PubmarineSubmarine/pubmarine-submarine/images/PubSubColorShiftedTransparent.png

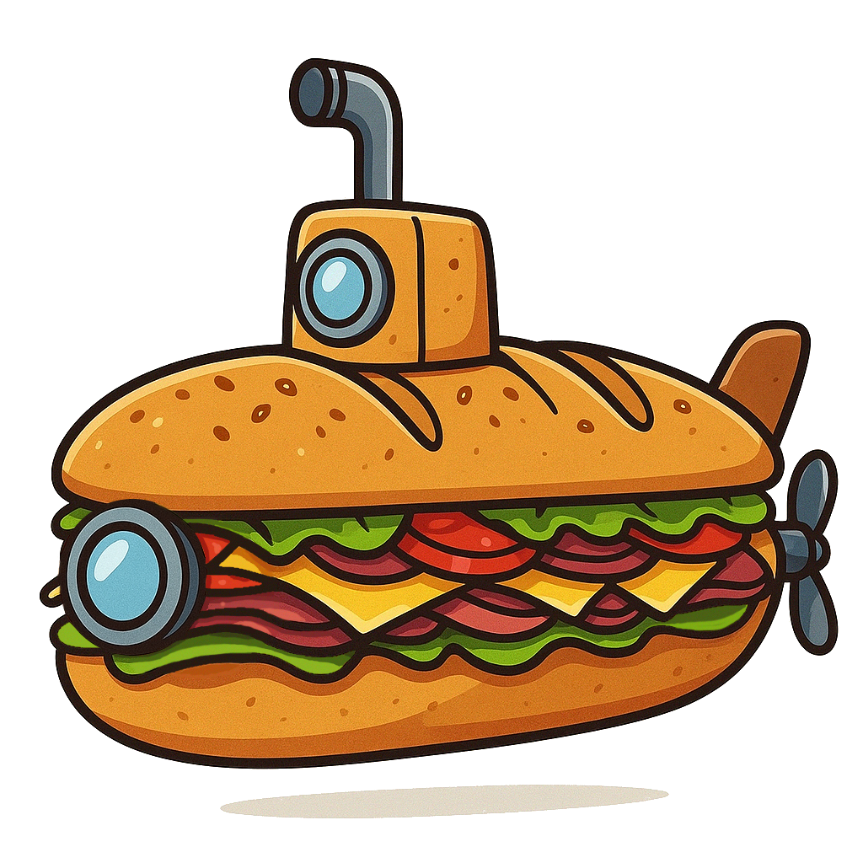
images/PubSubColorShiftedTransparent.png
