PubmarineSubmarine/pubmarine-submarine/images/PubSubBW1.png

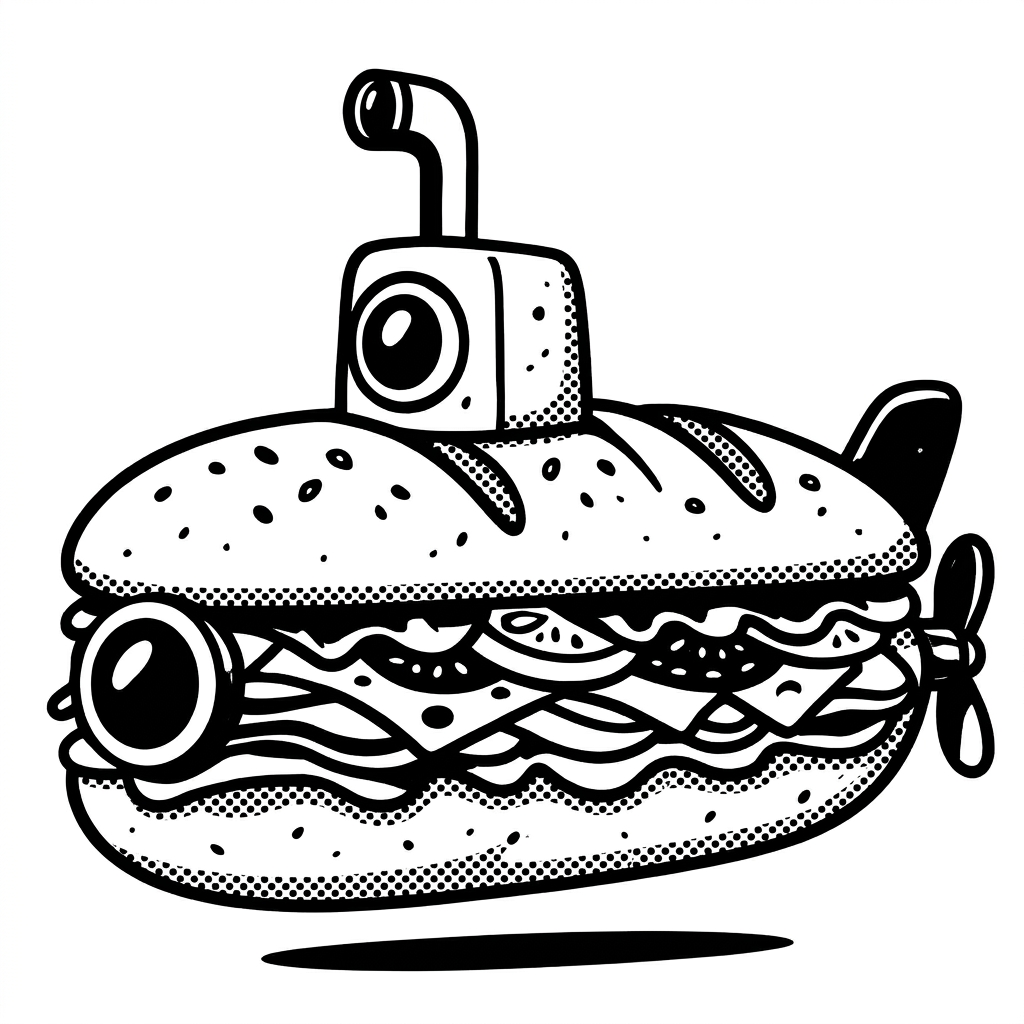
images/PubSubBW1.png
