PubmarineSubmarine/pubmarine-submarine/images/PubSubBW2.png

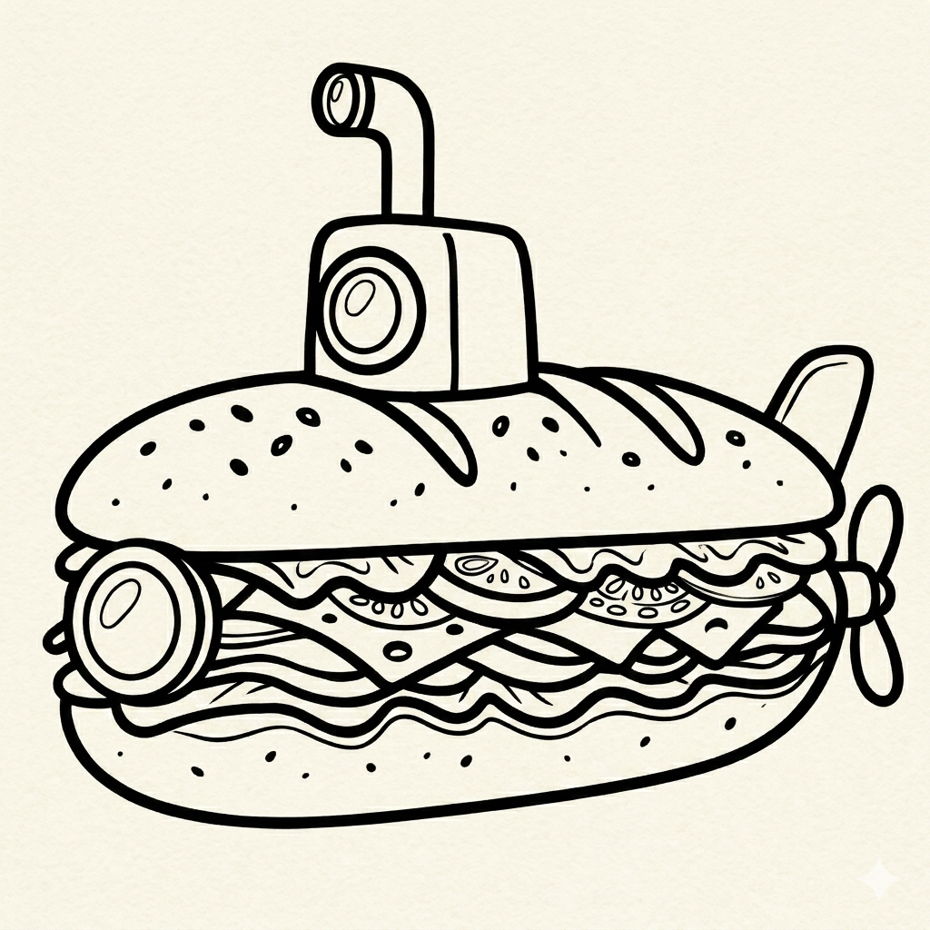
images/PubSubBW2.png
