PubmarineSubmarine/pubmarine-submarine/pcb/pubmarine-submarine.step

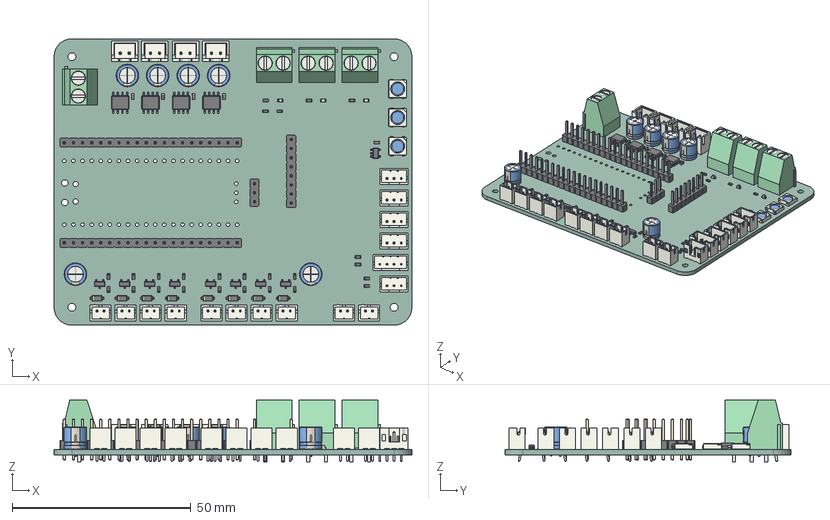
[picture p4: CAD file, 2025-08-23]
pcb/pubmarine-submarine.step
100.0 x 80.0 x 17.3 mm
JST_PH_B3B-PH-K_1x03_P2.00mm_Vertical x 5
CP_Radial_D6.3mm_P2.50mm x 6
R_0603_1608Metric x 25
JST_XH_B2B-XH-A_1x02_P2.50mm_Vertical x 4
C_0603_1608Metric x 5
JST_PH_B2B-PH-K_1x02_P2.00mm_Vertical x 10
LED_WS2812B_PLCC4_5.0x5.0mm_P3.2mm x 3
SOT-23 x 8
SO-8_3.9x4.9mm_P1.27mm x 4
TerminalBlock_Phoenix_MKDS-1,5-2_1x02_P5.00mm_Horizontal x 5
PinHeader_1x08_P2.54mm_Vertical
D_SOD-123 x 8
SOT-23-5
LED_0603_1608Metric x 3
PinHeader_1x20_P2.54mm_Vertical x 2
JST_PH_B4B-PH-K_1x04_P2.00mm_Vertical
PinHeader_1x03_P2.54mm_Vertical
pubmarine-submarine_PCB
