PubmarineSubmarine/pubmarine-submarine/web/static/subsanwich.obj

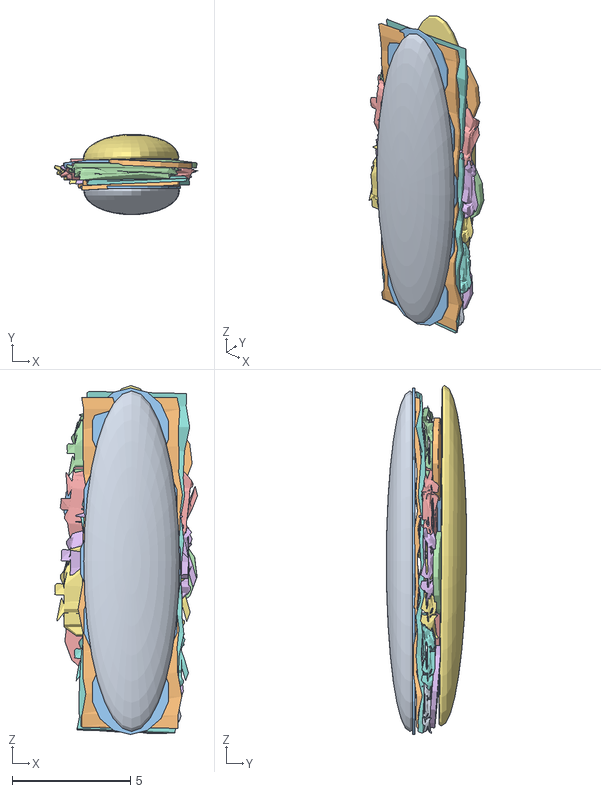
[picture p5: CAD file, 2026-04-18]
web/static/subsanwich.obj
6.06 x 3.40 x 14.8
bread_Sphere
meat_Cube.003
Cheese_Cylinder.002
lettuce_green
lettuce.001_green
lettuce.002_green
lettuce.003_green
lettuce.004_green
lettuce.005_green
Cylinder_Cylinder.008
Cylinder.001_Cylinder.008
Cylinder.002_Cylinder.008
Cylinder.003_Cylinder.008
Cylinder.004_Cylinder.008
bread.001_Sphere
meat.001_Cube.003
