PubmarineSubmarine/pubmarine-submarine/pcb/pubmarine-submarine.kicad_pcb

## KiCad design pcb/pubmarine-submarine.kicad_pcb (2026-05-04)

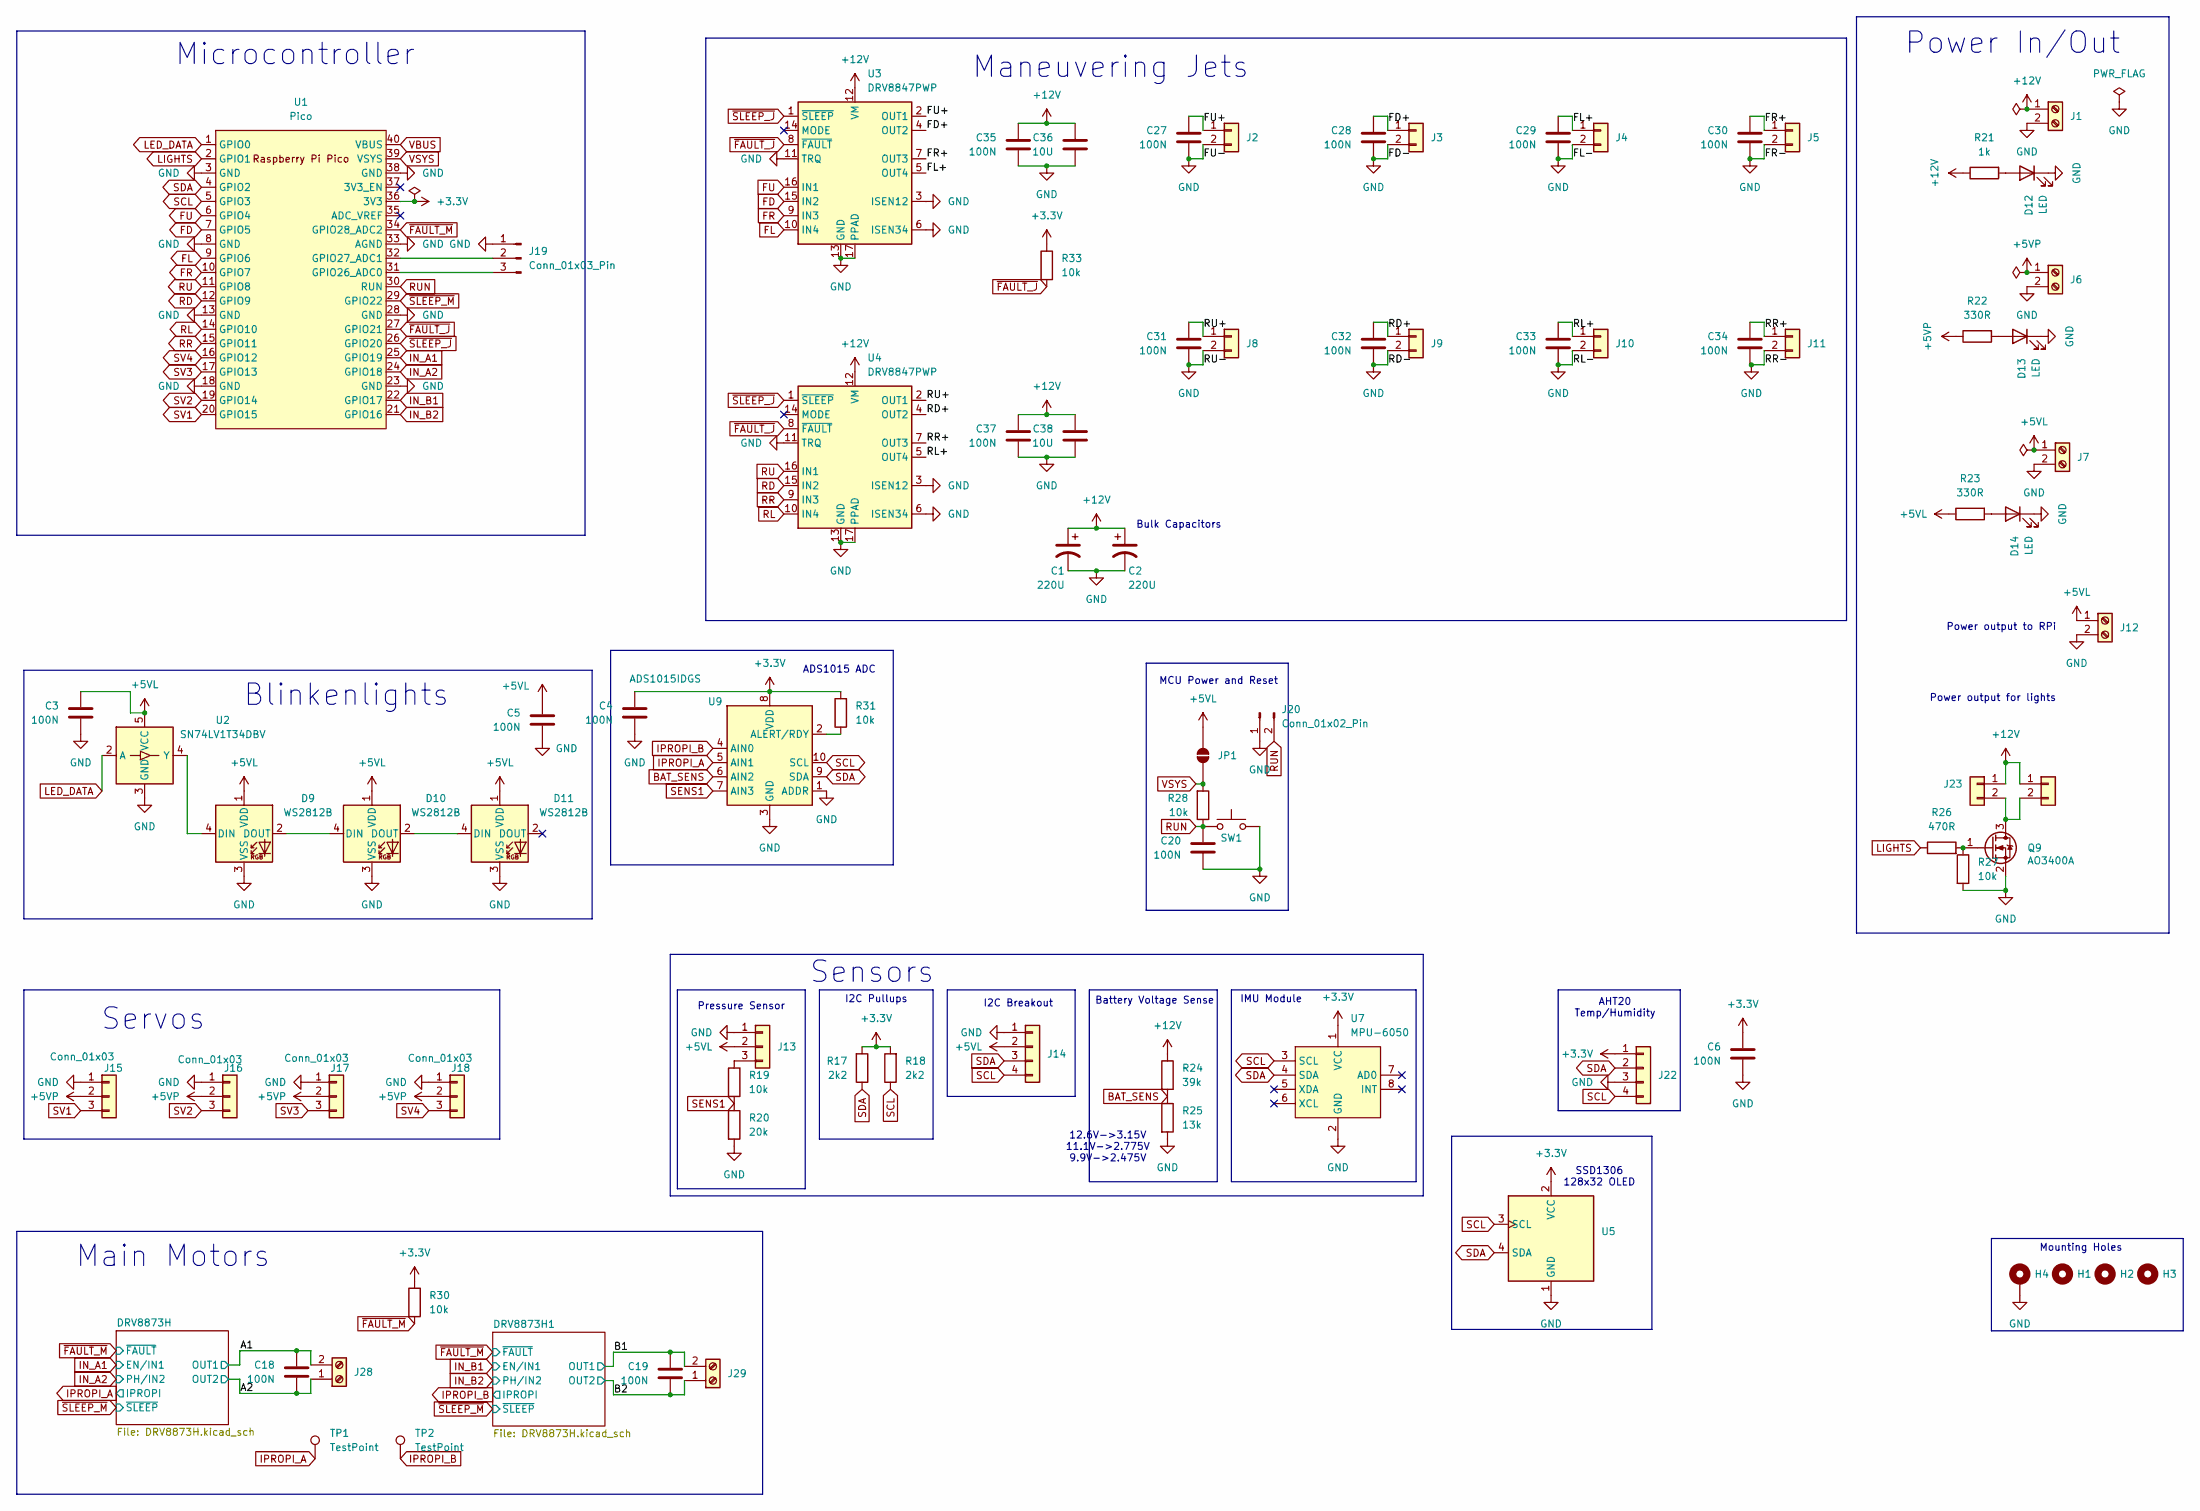
[picture p6: schematic pubmarine-submarine.kicad_sch]

Parts:
C1, C2: 220U; CP_Radial_D6.3mm_P2.50mm
C3, C4, C5, C6, C18, C19, C20, C27, C28, C29, C30, C31, C32, C33, C34, C35, C37: 100N; C_0603_1608Metric_Pad1.08x0.95mm_HandSolder
C36, C38: 10U; C_0603_1608Metric_Pad1.08x0.95mm_HandSolder
D9, D10, D11: WS2812B; LED_WS2812B_PLCC4_5.0x5.0mm_P3.2mm
D12, D13, D14: LED; LED_0603_1608Metric_Pad1.05x0.95mm_HandSolder
H1, H2, H3: MountingHole; MountingHole_2.2mm_M2
H4: MountingHole_Pad; MountingHole_2.2mm_M2_Pad
J1, J6, J7, J12, J28, J29: Screw_Terminal_01x02; TerminalBlock_Altech_AK300-2_P5.00mm
J2, J3, J4, J5, J8, J9, J10, J11, J23, J24: Conn_01x02; JST_PH_B2B-PH-K_1x02_P2.00mm_Vertical
J13, J15, J16, J17, J18: Conn_01x03; JST_PH_B3B-PH-K_1x03_P2.00mm_Vertical
J14: Conn_01x04; JST_PH_B4B-PH-K_1x04_P2.00mm_Vertical
J19: Conn_01x03_Pin; PinHeader_1x03_P2.54mm_Vertical
J20: Conn_01x02_Pin; PinHeader_1x02_P2.54mm_Vertical
J22: Conn_01x04; PinHeader_1x04_P2.54mm_Vertical
JP1: Jumper_2_Open; SolderJumper-2_P1.3mm_Open_RoundedPad1.0x1.5mm
Q9: AO3400A; SOT-23_Handsoldering
R17, R18: 2k2; R_0603_1608Metric_Pad0.98x0.95mm_HandSolder
R19, R27, R28, R30, R31, R33: 10k; R_0603_1608Metric_Pad0.98x0.95mm_HandSolder
R20: 20k; R_0603_1608Metric_Pad0.98x0.95mm_HandSolder
R21: 1k; R_0603_1608Metric_Pad0.98x0.95mm_HandSolder
R22, R23: 330R; R_0603_1608Metric_Pad0.98x0.95mm_HandSolder
R24: 39k; R_0603_1608Metric_Pad0.98x0.95mm_HandSolder
R25: 13k; R_0603_1608Metric_Pad0.98x0.95mm_HandSolder
R26: 470R; R_0603_1608Metric_Pad0.98x0.95mm_HandSolder
SW1: SW_Push; SW_PUSH_6mm
TP1, TP2: TestPoint; TestPoint_Pad_D1.0mm
U1: Pico; RPi_Pico_SMD_TH
U2: SN74LV1T34DBV; SOT-23-5
U3, U4: DRV8847PWP; HTSSOP-16-1EP_4.4x5mm_P0.65mm_EP3.4x5mm_Mask2.46x2.31mm_The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
U5: ER_OLEDM0.91_1x-I2C
U7: MPU-6050; MPU-6050_Module
U9: ADS1015IDGS; TSSOP-10_3x3mm_P0.5mm

Connections:
+3.3V: C4.1, C6.1, J22.1, R17.2, R18.2, R30.1, R31.2, R33.1, U1.36 (3V3), U5.2 (VCC), U7.1 (VCC), U9.8 (VDD)
+5VL: C3.1, C5.1, D9.1 (VDD), D10.1 (VDD), D11.1 (VDD), J7.1, J12.1, J13.2, J14.2, JP1.2 (B), R23.1, U2.5 (VCC)
+5VP: J6.1, J15.2, J16.2, J17.2, J18.2, R22.1
+12V: C1.1, C2.1, C35.1, C36.1, C37.1, C38.1, J1.1, J23.1, J24.1, R21.1, R24.1, U3.12 (VM), U4.12 (VM); also elsewhere on the board
/A1: C18.1, J28.2; also elsewhere on the board
/A2: C18.2, J28.1; also elsewhere on the board
/B1: C19.1, J29.2; also elsewhere on the board
/B2: C19.2, J29.1; also elsewhere on the board
/FD+: C28.1, J3.1, U3.4 (OUT2)
/FL+: C29.1, J4.1, U3.5 (OUT4)
/FR+: C30.1, J5.1, U3.7 (OUT3)
/FU+: C27.1, J2.1, U3.2 (OUT1)
/RD+: C32.1, J9.1, U4.4 (OUT2)
/RL+: C33.1, J10.1, U4.5 (OUT4)
/RR+: C34.1, J11.1, U4.7 (OUT3)
/RU+: C31.1, J8.1, U4.2 (OUT1)
BAT_SENS: R24.2, R25.1, U9.6 (AIN2)
FD: U1.7 (GPIO5), U3.15 (IN2)
FL: U1.9 (GPIO6), U3.10 (IN4)
FR: U1.10 (GPIO7), U3.9 (IN3)
FU: U1.6 (GPIO4), U3.16 (IN1)
GND: C1.2, C2.2, C3.2, C4.2, C5.2, C6.2, C20.2, C27.2, C28.2, C29.2, C30.2, C31.2, C32.2, C33.2, C34.2, C35.2, C36.2, C37.2, C38.2, D9.3 (VSS), D10.3 (VSS), D11.3 (VSS), D12.1 (K), D13.1 (K), D14.1 (K), H4.1 (1_1), J1.2, J2.2, J3.2, J4.2, J5.2, J6.2, J7.2, J8.2, J9.2, J10.2, J11.2, J12.2, J13.1, J14.1, J15.1, J16.1, J17.1, J18.1, J19.1, J20.1, J22.3, Q9.2 (S), R20.2, R25.2, R27.2, SW1.2, U1.3 (GND), U1.8 (GND), U1.13 (GND), U1.18 (GND), U1.23 (GND), U1.28 (GND), U1.33 (AGND), U1.38 (GND), U2.3 (GND), U3.3 (ISEN12), U3.6 (ISEN34), U3.11 (TRQ), U3.13 (GND), U3.17 (PPAD), U4.3 (ISEN12), U4.6 (ISEN34), U4.11 (TRQ), U4.13 (GND), U4.17 (PPAD), U5.1 (GND), U7.2 (GND), U9.1 (ADDR), U9.3 (GND); also elsewhere on the board
IN_A1: U1.25 (GPIO19); also elsewhere on the board
IN_A2: U1.24 (GPIO18); also elsewhere on the board
IN_B1: U1.22 (GPIO17); also elsewhere on the board
IN_B2: U1.21 (GPIO16); also elsewhere on the board
IPROPI_A: TP1.1 (1_1), U9.5 (AIN1); also elsewhere on the board
IPROPI_B: TP2.1 (1_1), U9.4 (AIN0); also elsewhere on the board
LED_DATA: U1.1 (GPIO0), U2.2 (A)
LIGHTS: R26.1, U1.2 (GPIO1)
unnamed: D9.4 (DIN), U2.4 (Y)
unnamed: D9.2 (DOUT), D10.4 (DIN)
unnamed: D10.2 (DOUT), D11.4 (DIN)
unnamed: D12.2 (A), R21.2
unnamed: D13.2 (A), R22.2
unnamed: D14.2 (A), R23.2
unnamed: J13.3, R19.1
unnamed: J19.2, U1.32 (GPIO27_ADC1)
unnamed: J19.3, U1.31 (GPIO26_ADC0)
unnamed: J23.2, J24.2, Q9.3 (D)
unnamed: Q9.1 (G), R26.2, R27.1
unnamed: R31.1, U9.2 (ALERT/RDY)
RD: U1.12 (GPIO9), U4.15 (IN2)
RL: U1.14 (GPIO10), U4.10 (IN4)
RR: U1.15 (GPIO11), U4.9 (IN3)
RU: U1.11 (GPIO8), U4.16 (IN1)
RUN: C20.1, J20.2, R28.1, SW1.1, U1.30 (RUN)
SCL: J14.4, J22.4, R18.1, U1.5 (GPIO3), U5.3 (SCL), U7.3 (SCL), U9.10 (SCL)
SDA: J14.3, J22.2, R17.1, U1.4 (GPIO2), U5.4 (SDA), U7.4 (SDA), U9.9 (SDA)
SENS1: R19.2, R20.1, U9.7 (AIN3)
SV1: J15.3, U1.20 (GPIO15)
SV2: J16.3, U1.19 (GPIO14)
SV3: J17.3, U1.17 (GPIO13)
SV4: J18.3, U1.16 (GPIO12)
VBUS: U1.40 (VBUS)
VSYS: JP1.1 (A), R28.2, U1.39 (VSYS)
~FAULT_J: R33.2, U1.27 (GPIO21), U3.8 (~FAULT), U4.8 (~FAULT)
~FAULT_M: R30.2, U1.34 (GPIO28_ADC2); also elsewhere on the board
~SLEEP_J: U1.26 (GPIO20), U3.1 (~SLEEP), U4.1 (~SLEEP)
~SLEEP_M: U1.29 (GPIO22); also elsewhere on the board

Notes on the sheet:
Pressure Sensor
Bulk Capacitors
Sensors
ADS1015 ADC
Power output to RPi
IMU Module
Main Motors
I2C Breakout
MCU Power and Reset
Servos
Battery Voltage Sense
SSD1306 128x32 OLED
Power In/Out
I2C Pullups
Microcontroller
12.6V->3.15V 11.1V->2.775V 9.9V->2.475V
AHT20 Temp/Humidity
Mounting Holes
Maneuvering Jets
Power output for lights
Blinkenlights

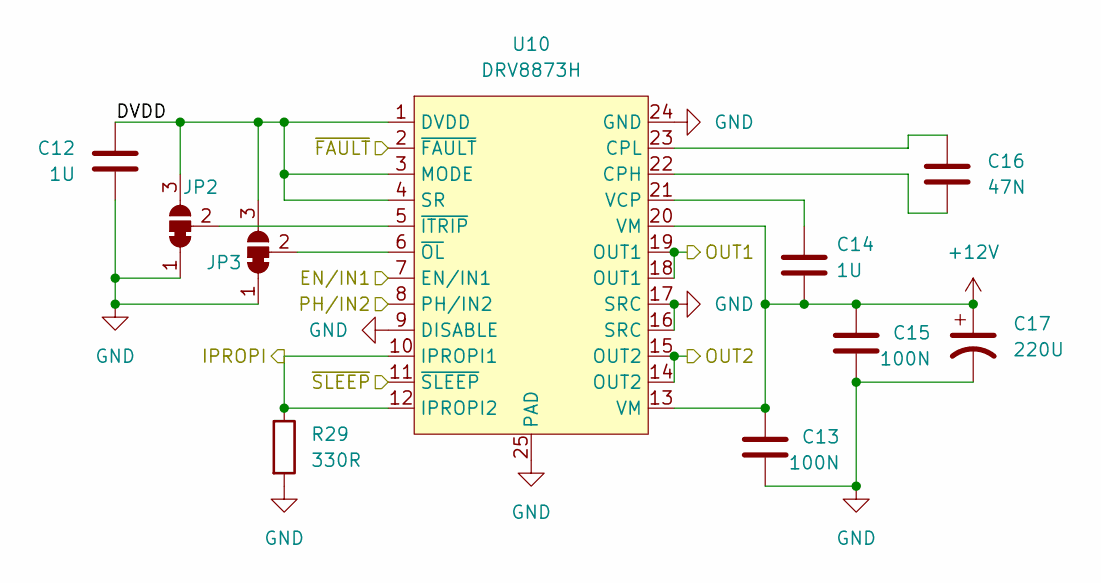
[picture p7: schematic DRV8873H.kicad_sch]

Parts:
C12, C14: 1U; C_0603_1608Metric_Pad1.08x0.95mm_HandSolder
C13, C15: 100N; C_0603_1608Metric_Pad1.08x0.95mm_HandSolder
C16: 47N; C_0603_1608Metric_Pad1.08x0.95mm_HandSolder
C17: 220U; CP_Radial_D6.3mm_P2.50mm
JP2, JP3: SolderJumper_3_Bridged12; SolderJumper-3_P1.3mm_Bridged12_RoundedPad1.0x1.5mm
R29: 330R; R_0603_1608Metric_Pad0.98x0.95mm_HandSolder
U10: DRV8873H; HTSSOP-24-1EP_4.4x7.8mm_P0.65mm_EP3.4x7.8mm_Mask2.44x3.42mm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

Connections:
+12V: C13.1, C14.2, C15.1, C17.1, U10.13 (VM), U10.20 (VM); also elsewhere on the board
/A1: U10.18 (OUT1), U10.19 (OUT1); also elsewhere on the board
/A2: U10.14 (OUT2), U10.15 (OUT2); also elsewhere on the board
/DRV8873H/DVDD: C12.1, JP2.3 (B), JP3.3 (B), U10.1 (DVDD), U10.3 (MODE), U10.4 (SR)
GND: C12.2, C13.2, C15.2, C17.2, JP2.1 (A), JP3.1 (A), R29.2, U10.9 (DISABLE), U10.16 (SRC), U10.17 (SRC), U10.24 (GND), U10.25 (PAD); also elsewhere on the board
IN_A1: U10.7 (EN/IN1); also elsewhere on the board
IN_A2: U10.8 (PH/IN2); also elsewhere on the board
IPROPI_A: R29.1, U10.10 (IPROPI1), U10.12 (IPROPI2); also elsewhere on the board
unnamed: JP2.2 (C), U10.5 (~ITRIP)
unnamed: JP3.2 (C), U10.6 (~OL)
unnamed: C16.2, U10.22 (CPH)
unnamed: C16.1, U10.23 (CPL)
unnamed: C14.1, U10.21 (VCP)
~FAULT_M: U10.2 (~FAULT); also elsewhere on the board
~SLEEP_M: U10.11 (~SLEEP); also elsewhere on the board

Parts of its further copies:
C21, C23: 1U; C_0603_1608Metric_Pad1.08x0.95mm_HandSolder
C22, C24: 100N; C_0603_1608Metric_Pad1.08x0.95mm_HandSolder
C25: 47N; C_0603_1608Metric_Pad1.08x0.95mm_HandSolder
C26: 220U; CP_Radial_D6.3mm_P2.50mm
JP4, JP5: SolderJumper_3_Bridged12; SolderJumper-3_P1.3mm_Bridged12_RoundedPad1.0x1.5mm
R32: 330R; R_0603_1608Metric_Pad0.98x0.95mm_HandSolder
U11: DRV8873H; HTSSOP-24-1EP_4.4x7.8mm_P0.65mm_EP3.4x7.8mm_Mask2.44x3.42mm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

Connections of its further copies:
+12V: C22.1, C23.2, C24.1, C26.1, U11.13 (VM), U11.20 (VM); also elsewhere on the board
/B1: U11.18 (OUT1), U11.19 (OUT1); also elsewhere on the board
/B2: U11.14 (OUT2), U11.15 (OUT2); also elsewhere on the board
/DRV8873H1/DVDD: C21.1, JP4.3 (B), JP5.3 (B), U11.1 (DVDD), U11.3 (MODE), U11.4 (SR)
GND: C21.2, C22.2, C24.2, C26.2, JP4.1 (A), JP5.1 (A), R32.2, U11.9 (DISABLE), U11.16 (SRC), U11.17 (SRC), U11.24 (GND), U11.25 (PAD); also elsewhere on the board
IN_B1: U11.7 (EN/IN1); also elsewhere on the board
IN_B2: U11.8 (PH/IN2); also elsewhere on the board
IPROPI_B: R32.1, U11.10 (IPROPI1), U11.12 (IPROPI2); also elsewhere on the board
unnamed: JP4.2 (C), U11.5 (~ITRIP)
unnamed: JP5.2 (C), U11.6 (~OL)
unnamed: C25.2, U11.22 (CPH)
unnamed: C25.1, U11.23 (CPL)
unnamed: C23.1, U11.21 (VCP)
~FAULT_M: U11.2 (~FAULT); also elsewhere on the board
~SLEEP_M: U11.11 (~SLEEP); also elsewhere on the board

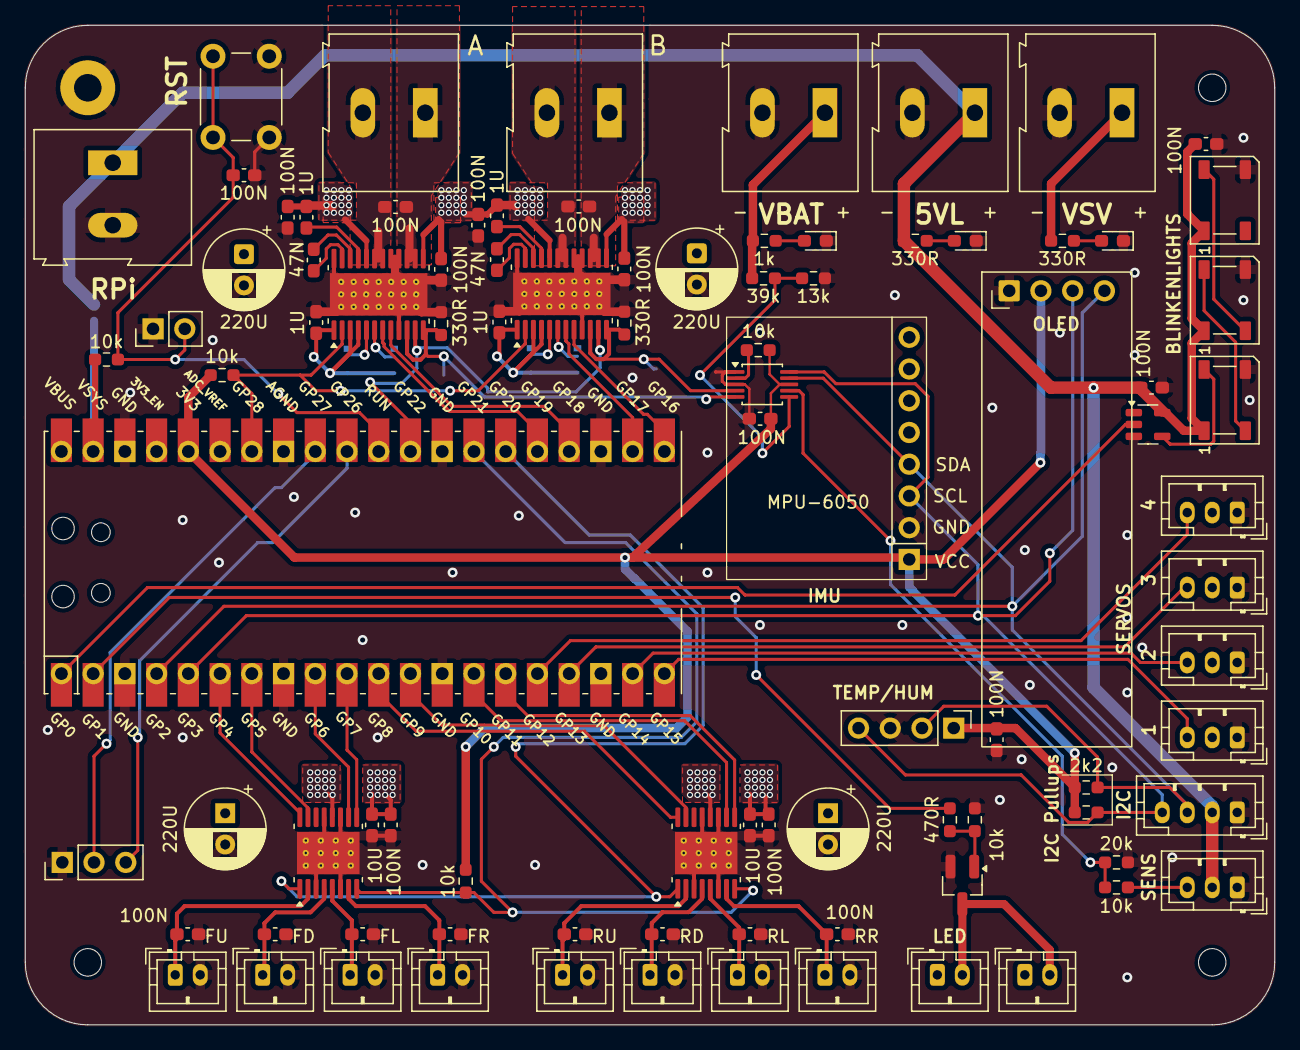
[picture p8: board pubmarine-submarine.kicad_pcb from above]

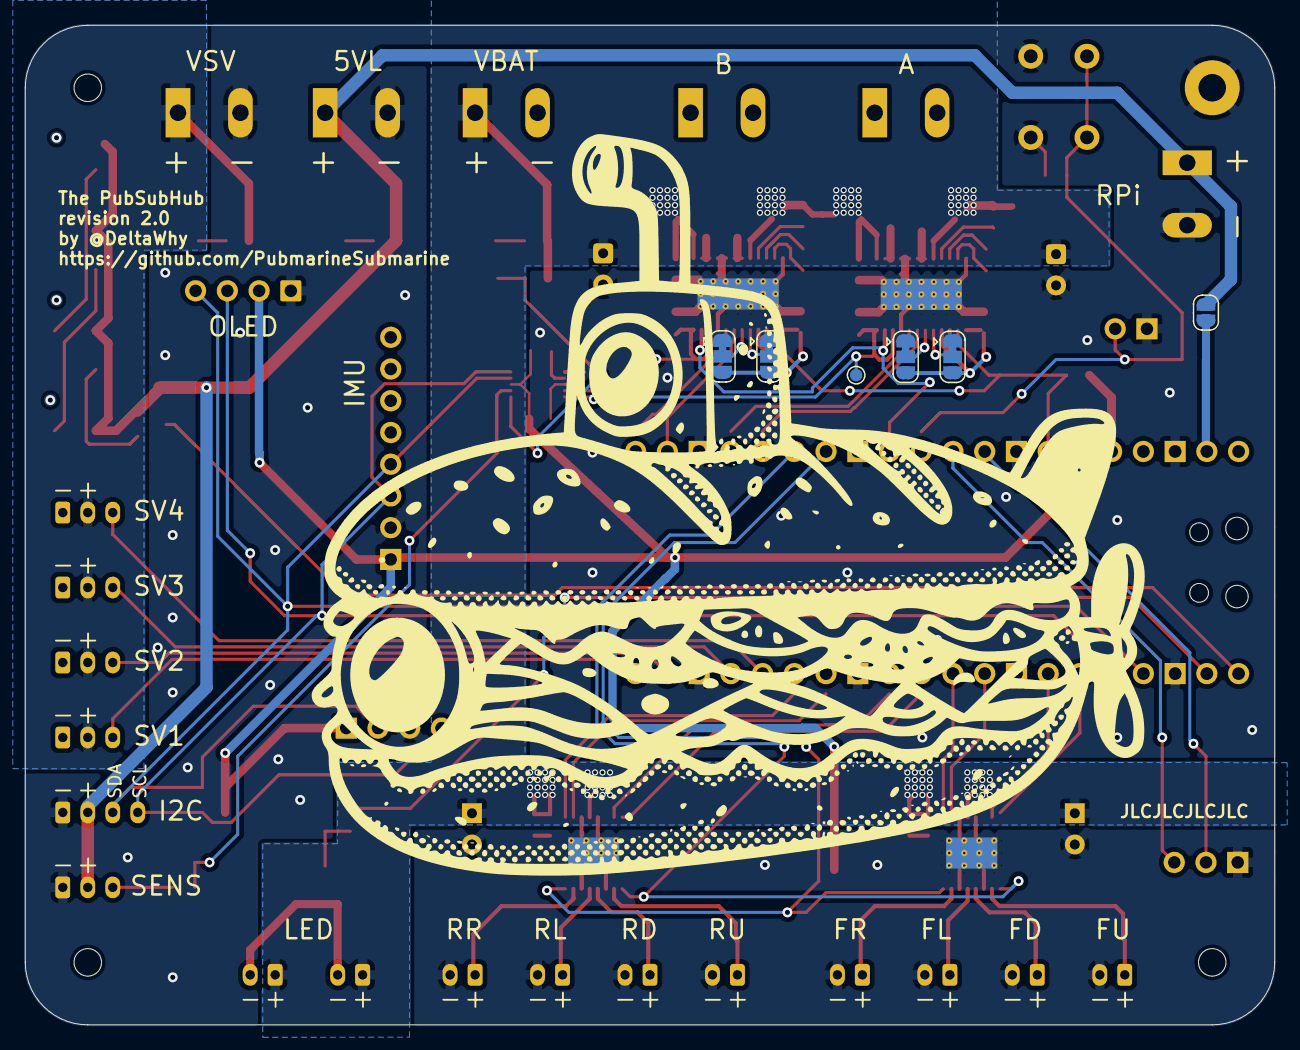
[picture p9: board pubmarine-submarine.kicad_pcb from below]

Board: 4 copper layers, 100.0 x 80.0 mm, 103 parts (7 on the bottom side), 71 nets.
