PubmarineSubmarine/pubmarine-submarine/pcb/Pump.kicad_block/Pump.kicad_pcb

## KiCad design pcb/Pump.kicad_block/Pump.kicad_pcb (2026-05-04)

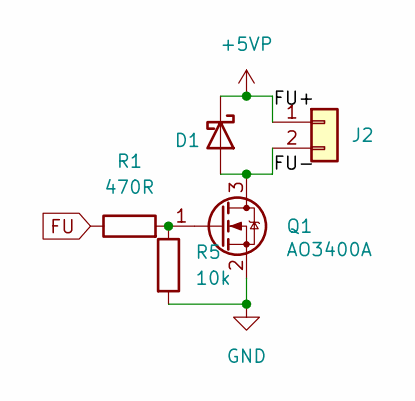
[picture p10: schematic Pump.kicad_sch]

Parts:
D1: B5819W; D_SOD-123
J2: Conn_01x02; JST_PH_B2B-PH-K_1x02_P2.00mm_Vertical
Q1: AO3400A; SOT-23_Handsoldering
R1: 470R; R_0603_1608Metric_Pad0.98x0.95mm_HandSolder
R5: 10k; R_0603_1608Metric_Pad0.98x0.95mm_HandSolder

Connections:
+5VP: D1.1 (K), J2.1
/FU-: D1.2 (A), J2.2, Q1.3 (D)
FU: R1.1
GND: Q1.2 (S), R5.2
unnamed: Q1.1 (G), R1.2, R5.1

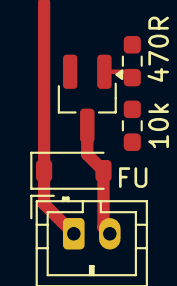
[picture p11: board Pump.kicad_pcb from above]

Board: 2 copper layers, 5 parts (0 on the bottom side), 4 nets.
