PubmarineSubmarine/pubmarine-submarine/web/app/main.py

import json
import logging
from asyncio import TaskGroup
from contextlib import asynccontextmanager

import httpx
from fastapi import (
    FastAPI,
    HTTPException,
    Request,
    Response,
    WebSocket,
    WebSocketDisconnect,
)
from fastapi.responses import HTMLResponse, RedirectResponse, StreamingResponse
from fastapi.staticfiles import StaticFiles
from fastapi.templating import Jinja2Templates
from gpio import cleanup_gpio, initialize_gpio
from plumbing import Plumbing

plumbing = Plumbing()


@asynccontextmanager
async def plumbing_lifespan(_app: FastAPI):
    await plumbing.init()
    initialize_gpio()
    yield
    await plumbing.shutdown()
    cleanup_gpio()


app = FastAPI(lifespan=plumbing_lifespan, title="Pubmarine Submarine", version="0.1.0")

# Mount static files
app.mount("/static", StaticFiles(directory="static"), name="static")

# Templates
templates = Jinja2Templates(directory="templates")

# Set up logging for gamepad data
logging.basicConfig(level=logging.DEBUG)
logger = logging.getLogger(__name__)


@app.get("/", response_class=HTMLResponse)
async def gamepad_demo(request: Request):
    """Serve the gamepad demo page."""
    return templates.TemplateResponse("gamepad.html", {"request": request})


@app.get("/gamepad")
async def gamepad_page(request: Request):
    # redirect response to /
    """returns a RedirectResponse to hte index at /"""
    return RedirectResponse(url="/")


@app.websocket("/ws/gamepad")
async def websocket_endpoint(websocket: WebSocket):
    await websocket.accept()
    plumbing.ws_connect(websocket)

    try:
        async with TaskGroup() as tg:
            while True:
                # Receive gamepad data from client
                data = await websocket.receive_text()
                gamepad_data = json.loads(data)

                tg.create_task(handle_gamepad_data(gamepad_data))

    except WebSocketDisconnect:
        await plumbing.ws_disconnect(websocket)
    except Exception as e:
        logger.error(f"WebSocket error: {e}")
        await plumbing.ws_disconnect(websocket)


async def handle_gamepad_data(data: dict):
    try:
        await log_gamepad_data(data)
    except Exception:
        logger.exception("Error handling websocket message")


async def log_gamepad_data(data: dict):
    """Log gamepad data in a readable format."""
    event_type = data.get("type", "unknown")

    if event_type == "button_press":
        button_name = data.get("button_name", "Unknown")
        value = data["value"]
        button_index = data["button_index"]
        await plumbing.button_pressed(button_index, value)
        logger.info(f"🎮 BUTTON: {button_name} pressed (value: {value:.3f})")

    elif event_type == "button_release":
        button_name = data.get("button_name", "Unknown")
        value = data["value"]
        button_index = data["button_index"]
        await plumbing.button_released(button_index, value)
        logger.info(f"🎮 BUTTON: {button_name} released (value: {value:.3f})")

    elif event_type == "analog_stick":
        stick = data.get("stick", "unknown")
        x = data.get("x", 0)
        y = data.get("y", 0)
        await plumbing.stick_moved(stick, x, y)
        logger.info(f"🕹️  STICK: {stick} moved to X:{x:.3f}, Y:{y:.3f}")

    elif event_type == "analog_trigger":
        trigger = data.get("trigger", "unknown")
        value = data.get("value", 0)
        await plumbing.trigger_moved(trigger, value)
        logger.info(f"🕹️  TRIGGER: {trigger} moved to:{value:.3f}")

    elif event_type == "gamepad_connected":
        gamepad_id = data.get("gamepad_id", "Unknown")
        logger.info(f"🔌 GAMEPAD CONNECTED: {gamepad_id}")

    elif event_type == "gamepad_disconnected":
        logger.info("🔌 GAMEPAD DISCONNECTED")

    elif event_type == "gamepad_state":
        # full gamepad state comes in here
        # logger.info(f"🎮 GAMEPAD DATA: {data['gamepad']}")
        pass
    elif event_type == "console_command":
        await plumbing.console_cmd(data["text"])

    elif event_type == "heartbeat":
        await plumbing.heartbeat()

    elif event_type == "stop":
        await plumbing.stop()


WEBRTC_SERVER_URL = "http://localhost:8889"


@app.api_route("/cam", methods=["GET", "POST", "PUT", "DELETE", "PATCH", "OPTIONS"])
async def proxy_cam(request: Request):
    """
    Proxy all requests to the WebRTC server at /cam endpoint
    """
    try:
        # Construct the target URL
        target_url = f"{WEBRTC_SERVER_URL}/cam"

        # Get request body if it exists
        body = await request.body()

        # Prepare headers (exclude host header to avoid conflicts)
        headers = dict(request.headers)
        if "host" in headers:
            del headers["host"]

        async with httpx.AsyncClient(timeout=30.0) as client:
            # Forward the request to the WebRTC server
            response = await client.request(
                method=request.method,
                url=target_url,
                headers=headers,
                content=body,
                params=request.query_params,
            )

            # For streaming responses (like video streams)
            if "stream" in response.headers.get("content-type", "").lower():
                return StreamingResponse(
                    response.aiter_bytes(),
                    media_type=response.headers.get("content-type"),
                    headers=dict(response.headers),
                )

            # For regular responses
            return Response(
                content=response.content,
                status_code=response.status_code,
                headers=dict(response.headers),
                media_type=response.headers.get("content-type"),
            )

    except httpx.ConnectError:
        raise HTTPException(status_code=502, detail="WebRTC server is not available at localhost:8889")
    except httpx.TimeoutException:
        raise HTTPException(status_code=504, detail="Request to WebRTC server timed out")
    except Exception as e:
        raise HTTPException(status_code=500, detail=f"Proxy error: {str(e)}")


@app.api_route("/cam/{path:path}", methods=["GET", "POST", "PUT", "DELETE", "PATCH", "OPTIONS"])
async def proxy_cam_subpaths(path: str, request: Request):
    """
    Proxy requests to WebRTC server subpaths (e.g., /cam/stream, /cam/config)
    """
    try:
        # Construct the target URL with the subpath
        target_url = f"{WEBRTC_SERVER_URL}/cam/{path}"

        # Get request body if it exists
        body = await request.body()

        # Prepare headers (exclude host header to avoid conflicts)
        headers = dict(request.headers)
        if "host" in headers:
            del headers["host"]

        async with httpx.AsyncClient(timeout=30.0) as client:
            # Forward the request to the WebRTC server
            response = await client.request(
                method=request.method,
                url=target_url,
                headers=headers,
                content=body,
                params=request.query_params,
            )

            # For streaming responses
            if "stream" in response.headers.get("content-type", "").lower():
                return StreamingResponse(
                    response.aiter_bytes(),
                    media_type=response.headers.get("content-type"),
                    headers=dict(response.headers),
                )

            # For regular responses
            return Response(
                content=response.content,
                status_code=response.status_code,
                headers=dict(response.headers),
                media_type=response.headers.get("content-type"),
            )

    except httpx.ConnectError:
        raise HTTPException(status_code=502, detail="WebRTC server is not available at localhost:8889")
    except httpx.TimeoutException:
        raise HTTPException(status_code=504, detail="Request to WebRTC server timed out")
    except Exception as e:
        raise HTTPException(status_code=500, detail=f"Proxy error: {str(e)}")


if __name__ == "__main__":
    from pathlib import Path

    import uvicorn

    cert_file = Path("certs/cert.pem")
    key_file = Path("certs/key.pem")

    if cert_file.exists() and key_file.exists():
        print("Access at: https://localhost:8000")
        print("You may need to accept the self-signed certificate warning.")
        uvicorn.run(
            app,
            host="0.0.0.0",
            port=8000,
            ssl_keyfile=str(key_file),
            ssl_certfile=str(cert_file),
        )
    else:
        print("Access at: http://localhost:8000")
        uvicorn.run(app, host="0.0.0.0", port=8000)
