PubmarineSubmarine/pubmarine-submarine/firmware/pins_v1.py

import board


LED_DATA = board.GP0
W1 = board.GP1
SDA = board.GP2
SCL = board.GP3
FU = board.GP4
FD = board.GP5
FL = board.GP6
FR = board.GP7
RU = board.GP8
RD = board.GP9
RL = board.GP10
RR = board.GP11
SV4 = board.GP12
SV3 = board.GP13
SV2 = board.GP14
SV1 = board.GP15
W2 = board.GP16
Z1 = board.GP17
Z2 = board.GP18
Y1 = board.GP19
Y2 = board.GP20
X1 = board.GP21
X2 = board.GP22
SENS1 = board.GP26_A0
BAT_SENS = board.GP27_A1
