PubmarineSubmarine/pubmarine-submarine/(commit log)

2025-07-05 clean up and fixes
    [main.py]
2025-07-12 new PCB
    [pubmarine-submarine.kicad_pcb, pubmarine-submarine.kicad_sch]
2025-07-13 pcb updates
    [pubmarine-submarine.kicad_pcb, pubmarine-submarine.kicad_sch]
2025-07-18 pcb update
    [pubmarine-submarine.kicad_pcb, pubmarine-submarine.kicad_sch]
2025-07-25 pcb: IMU breakout and silkscreen cleanup
    [pubmarine-submarine.kicad_pcb, pubmarine-submarine.kicad_sch]
2025-07-27 silkscreen updates
    [pubmarine-submarine.kicad_pcb, pubmarine-submarine.kicad_sch]
2025-07-30 pcb: fix clearances
    [pubmarine-submarine.kicad_pcb, pubmarine-submarine.kicad_sch]
2025-08-07 descuff camera
2025-08-11 websocket buttons
2025-08-14 pcb: fix LSS pins, notes for other rev2 changes
    [pubmarine-submarine.kicad_pcb, pubmarine-submarine.kicad_sch]
2025-08-23 firmware: servo control
    [pubmarine-submarine.step]
2025-08-24 software: analog triggers, serial fixes
    [main.py, plumbing.py, protocol.py, serial_client.py]
2025-08-24 software: limit servo range to +/-45deg
2025-08-24 firmware: motor and servo control, status protocol
2025-08-26 whatever I didn't have pushed
    [main.py, plumbing.py, serial_client.py]
2025-08-30 firmware: error handling, fix stop command
    [code.py]
2025-10-05 sub 3d preview
    [subsanwich.obj]
2026-04-25 pcb v2 wip
    [pubmarine-submarine-CuBottom.gbr, pubmarine-submarine-CuTop.gbr, pubmarine-submarine-EdgeCuts.gbr, pubmarine-submarine-MaskBottom.gbr, pubmarine-submarine-MaskTop.gbr, pubmarine-submarine-NPTH.drl, pubmarine-submarine-PTH.drl, pubmarine-submarine-SilkBottom.gbr]
2026-04-26 wip: PCB rev2, motors mostly done?
    [DRV8873H.kicad_pcb, DRV8873H.kicad_sch, Pump.kicad_pcb, Pump.kicad_sch, VNH7070AS.kicad_sch, pubmarine-submarine.kicad_pcb, pubmarine-submarine.kicad_sch, untitled.kicad_sch]
2026-04-27 wip pcb
    [DRV8873H.kicad_pcb, DRV8873H.kicad_sch, pubmarine-submarine.kicad_pcb, pubmarine-submarine.kicad_sch]
2026-04-27 pcb rev2 done?
    [pubmarine-submarine.kicad_pcb, pubmarine-submarine.kicad_sch]
2026-04-27 pcb tweaks
    [pubmarine-submarine.kicad_pcb, pubmarine-submarine.kicad_sch]
2026-05-04 pcb: 1oz copper
    [pubmarine-submarine-CuBottom.gbr, pubmarine-submarine-CuIn1.gbr, pubmarine-submarine-CuIn2.gbr, pubmarine-submarine-CuTop.gbr, pubmarine-submarine-EdgeCuts.gbr, pubmarine-submarine-MaskBottom.gbr, pubmarine-submarine-MaskTop.gbr, pubmarine-submarine-NPTH.drl]
2026-05-23 fix serial read lag
    [code.py, config.py, controls.py, display.py, protocol.py]
